garyt72/Alarm-Panel/docs/pcb/images/power-plug-bottom-angle.png

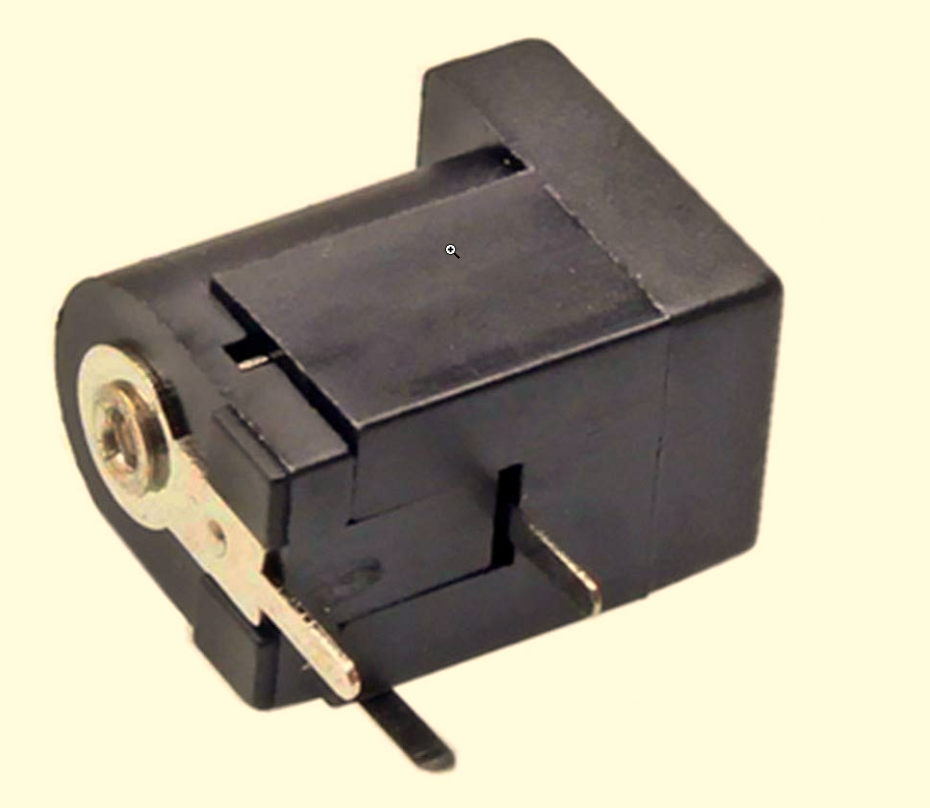
docs/pcb/images/power-plug-bottom-angle.png
