garyt72/Alarm-Panel/hardware/alarm-panel/Alarm Panel.pdf

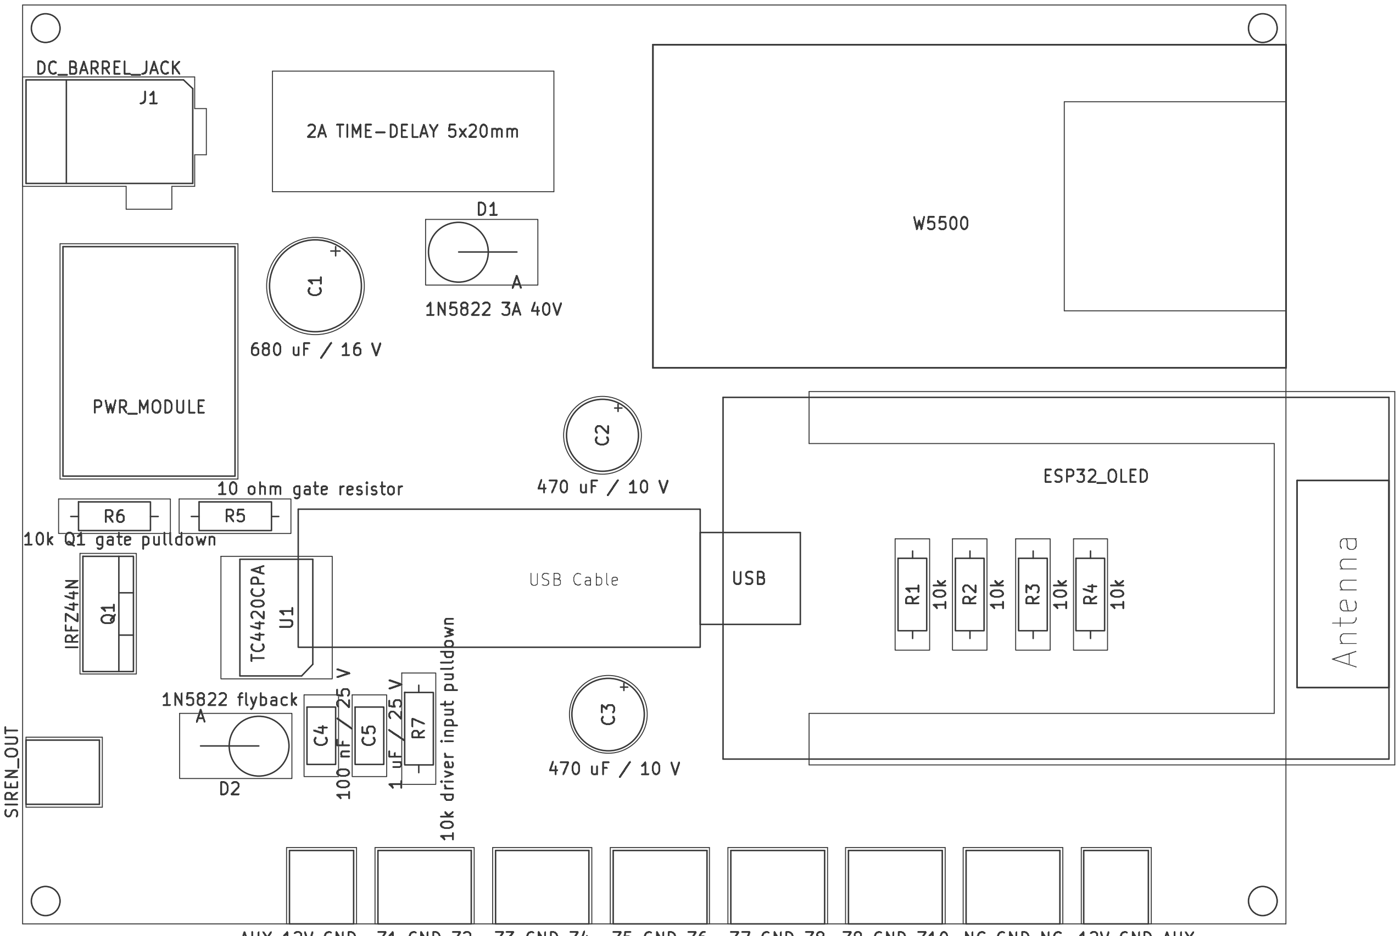
[picture p3: figure]

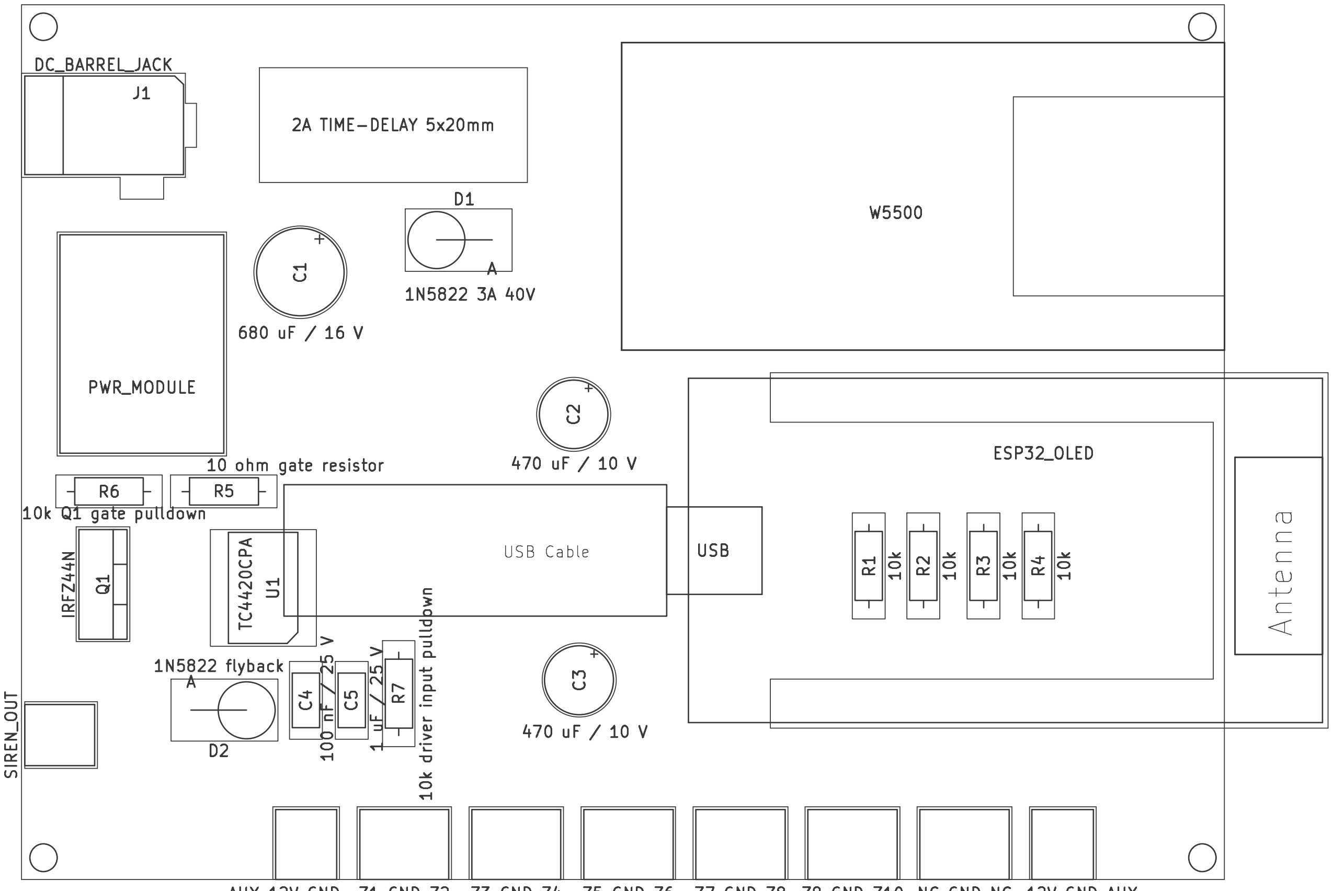
[picture p4: figure]
