garyt72/Alarm-Panel/docs/pcb/images/Fuse Holder Drawing.png

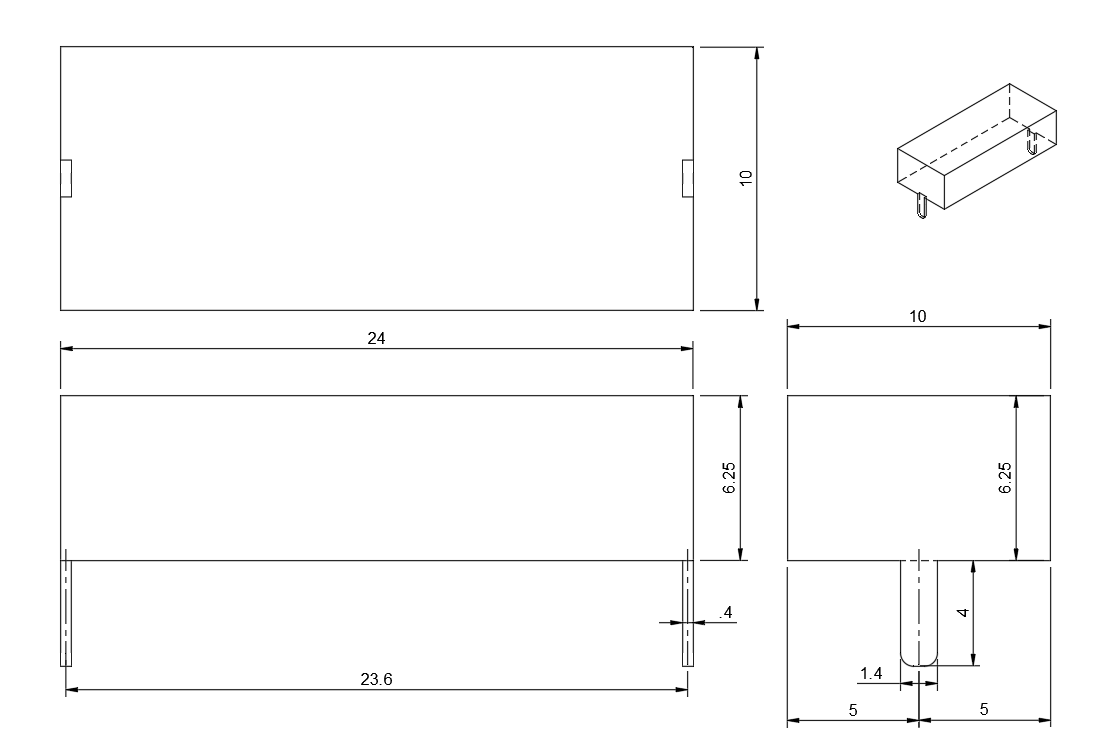
docs/pcb/images/Fuse Holder Drawing.png
