garyt72/Alarm-Panel/docs/pcb/images/power-plug-dimensions.png

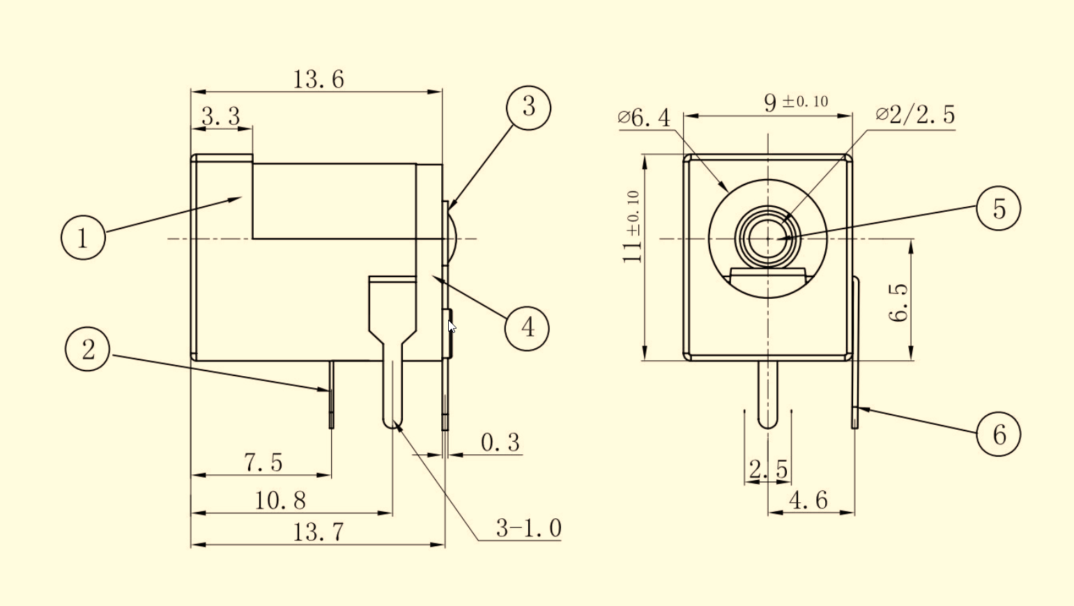
docs/pcb/images/power-plug-dimensions.png
