garyt72/Alarm-Panel/docs/pcb/images/w5500-bottom.png

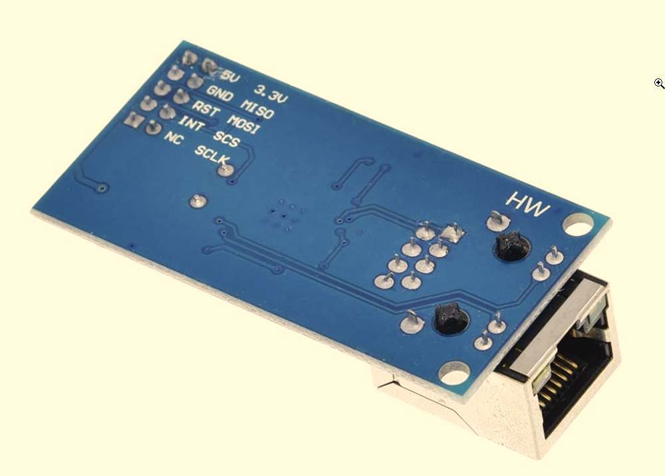
docs/pcb/images/w5500-bottom.png
