garyt72/Alarm-Panel/docs/pcb/images/w5500-dimensions.png

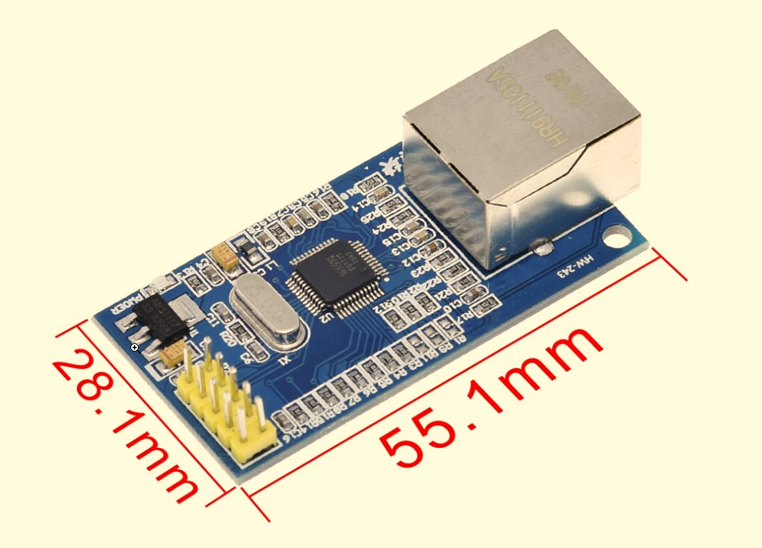
docs/pcb/images/w5500-dimensions.png
