garyt72/Alarm-Panel/docs/pcb/images/w5500-drawing.png

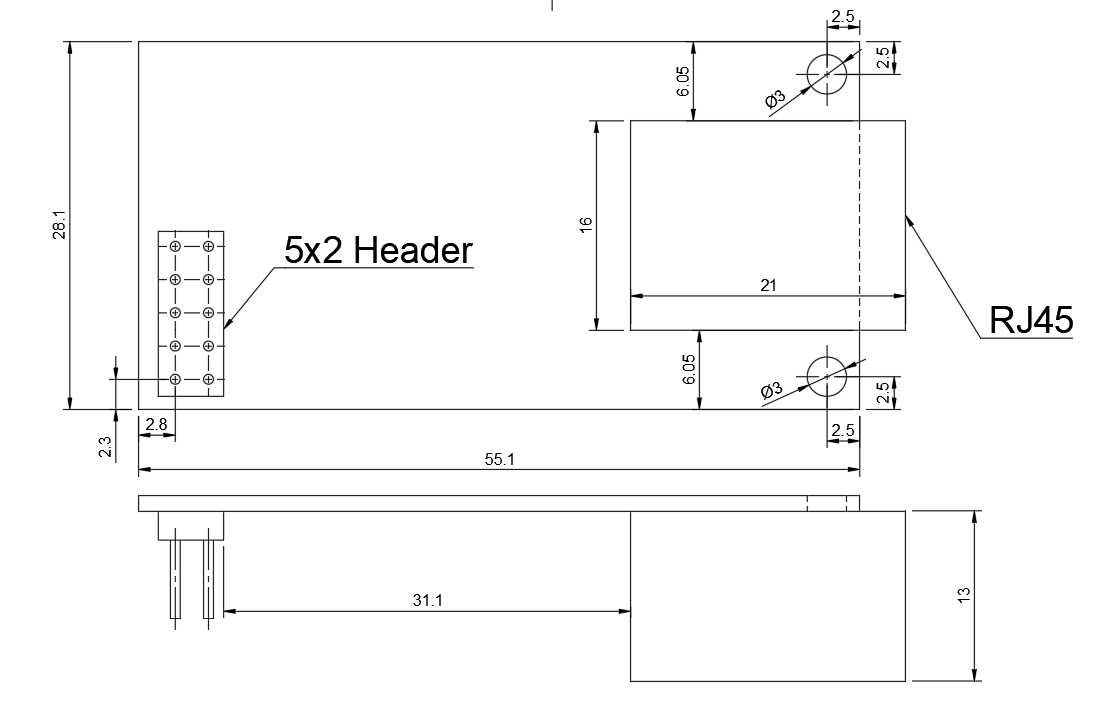
docs/pcb/images/w5500-drawing.png
