garyt72/Alarm-Panel/docs/pcb/images/w5500-top.jpg

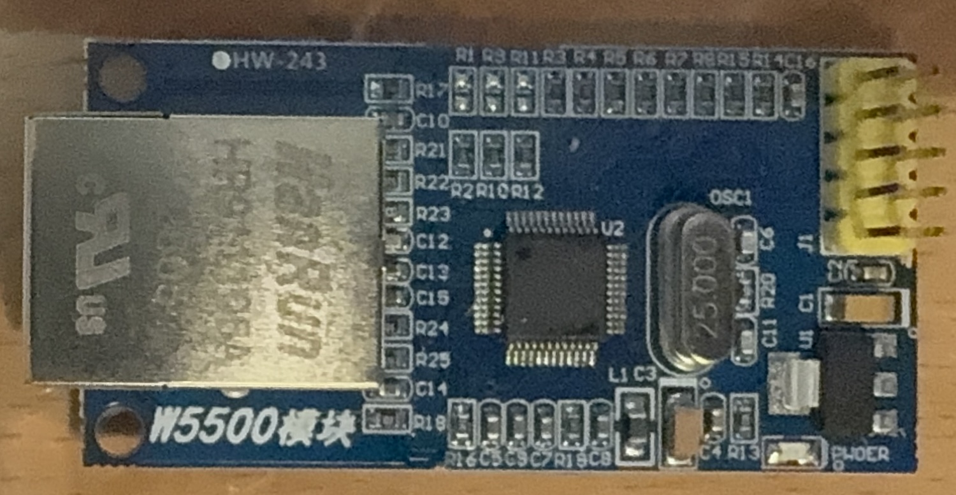
docs/pcb/images/w5500-top.jpg
