garyt72/Alarm-Panel/hardware/alarm-panel/3d-models/Fuse Holder.step

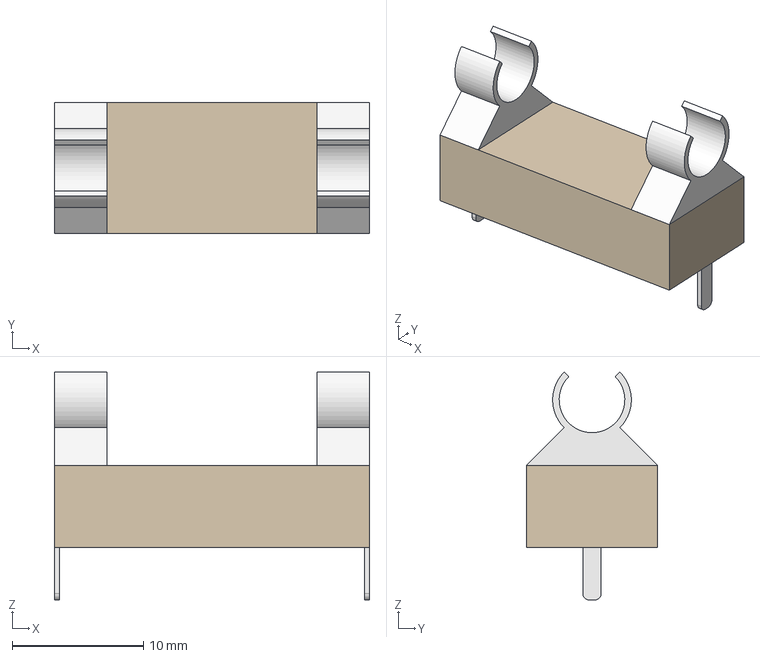
[picture p12: CAD file, 2026-10-27]
hardware/alarm-panel/3d-models/Fuse Holder.step
24.0 x 10.0 x 17.4 mm
