garyt72/Alarm-Panel/hardware/enclosure/3d-printing/PCB v1.0.0/Alarm Panel OLED case (PCB).step

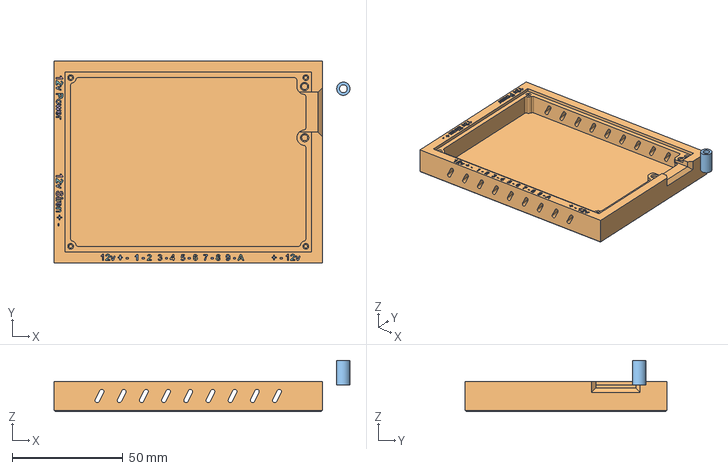
[picture p13: CAD file, 2026-11-01]
hardware/enclosure/3d-printing/PCB v1.0.0/Alarm Panel OLED case (PCB).step
133.4 x 91.0 x 23.0 mm
