garyt72/Alarm-Panel/hardware/alarm-panel/3d-models/Power Module.step

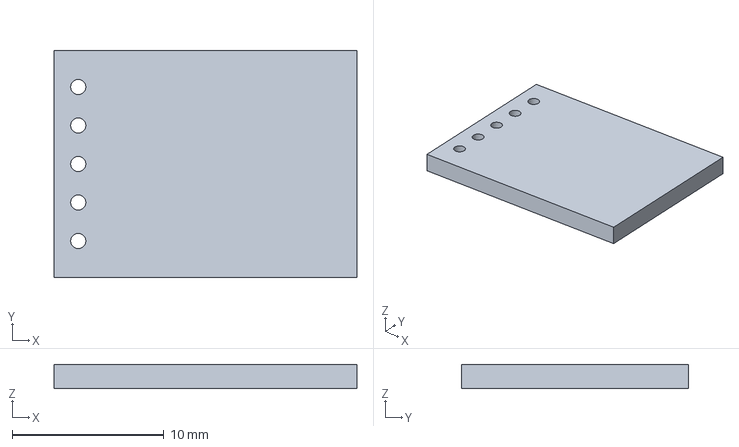
[picture p14: CAD file, 2026-10-27]
hardware/alarm-panel/3d-models/Power Module.step
20.0 x 15.0 x 1.60 mm
