garyt72/Alarm-Panel/hardware/enclosure/3d-printing/PCB v1.0.0/Alarm Panel OLED case (PCB) Ethernet Spacer.stl

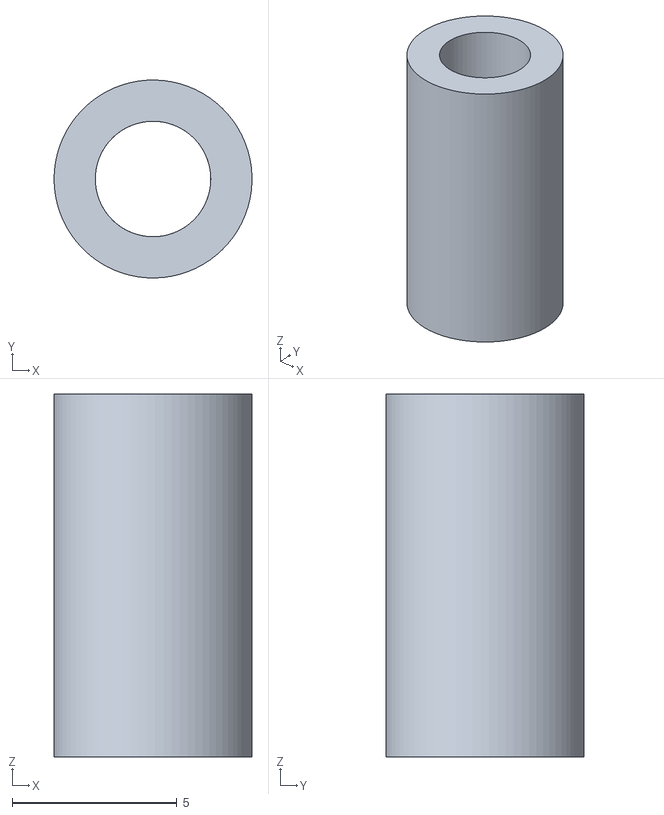
[picture p15: CAD file, 2026-11-01]
hardware/enclosure/3d-printing/PCB v1.0.0/Alarm Panel OLED case (PCB) Ethernet Spacer.stl
6.00 x 6.00 x 11.0
