garyt72/Alarm-Panel/hardware/alarm-panel/3d-models/esp32_Wroom_CP2102_Ideaspark_0.96in_OLED_USBmicro.step

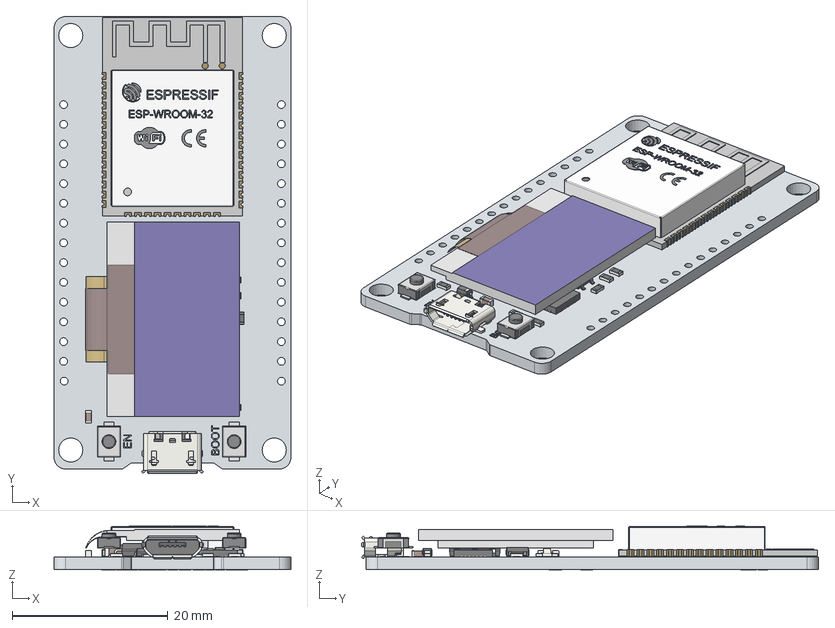
[picture p16: CAD file, 2026-10-27]
hardware/alarm-panel/3d-models/esp32_Wroom_CP2102_Ideaspark_0.96in_OLED_USBmicro.step
30.5 x 58.8 x 5.60 mm
