garyt72/Alarm-Panel/hardware/alarm-panel/3d-models/W5500_Ethernet_Module_HiLetgo.step

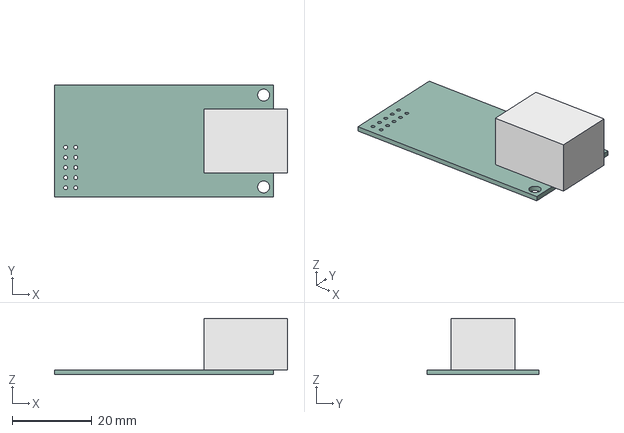
[picture p17: CAD file, 2026-10-27]
hardware/alarm-panel/3d-models/W5500_Ethernet_Module_HiLetgo.step
58.6 x 28.1 x 14.2 mm
