garyt72/Alarm-Panel/hardware/enclosure/3d-printing/legacy/Alarm Panel OLED case.stl

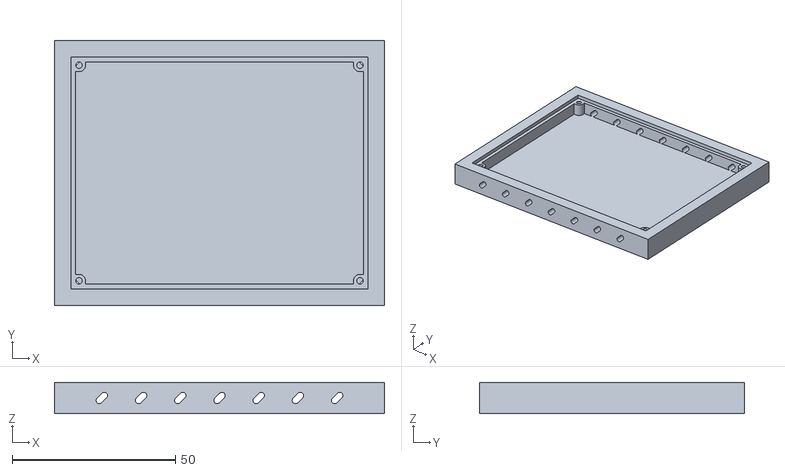
[picture p18: CAD file, 2026-10-25, an earlier design]
hardware/enclosure/3d-printing/legacy/Alarm Panel OLED case.stl
101.0 x 81.0 x 9.50
