garyt72/Alarm-Panel/(list of files, cad)

Other CAD files:
hardware/enclosure/3d-printing/PCB v1.0.0/Alarm Panel OLED case (PCB).stl
