garyt72/Alarm-Panel/hardware/alarm-panel/Alarm Panel.kicad_pcb

## KiCad design hardware/alarm-panel/Alarm Panel.kicad_pcb (2026-11-01)

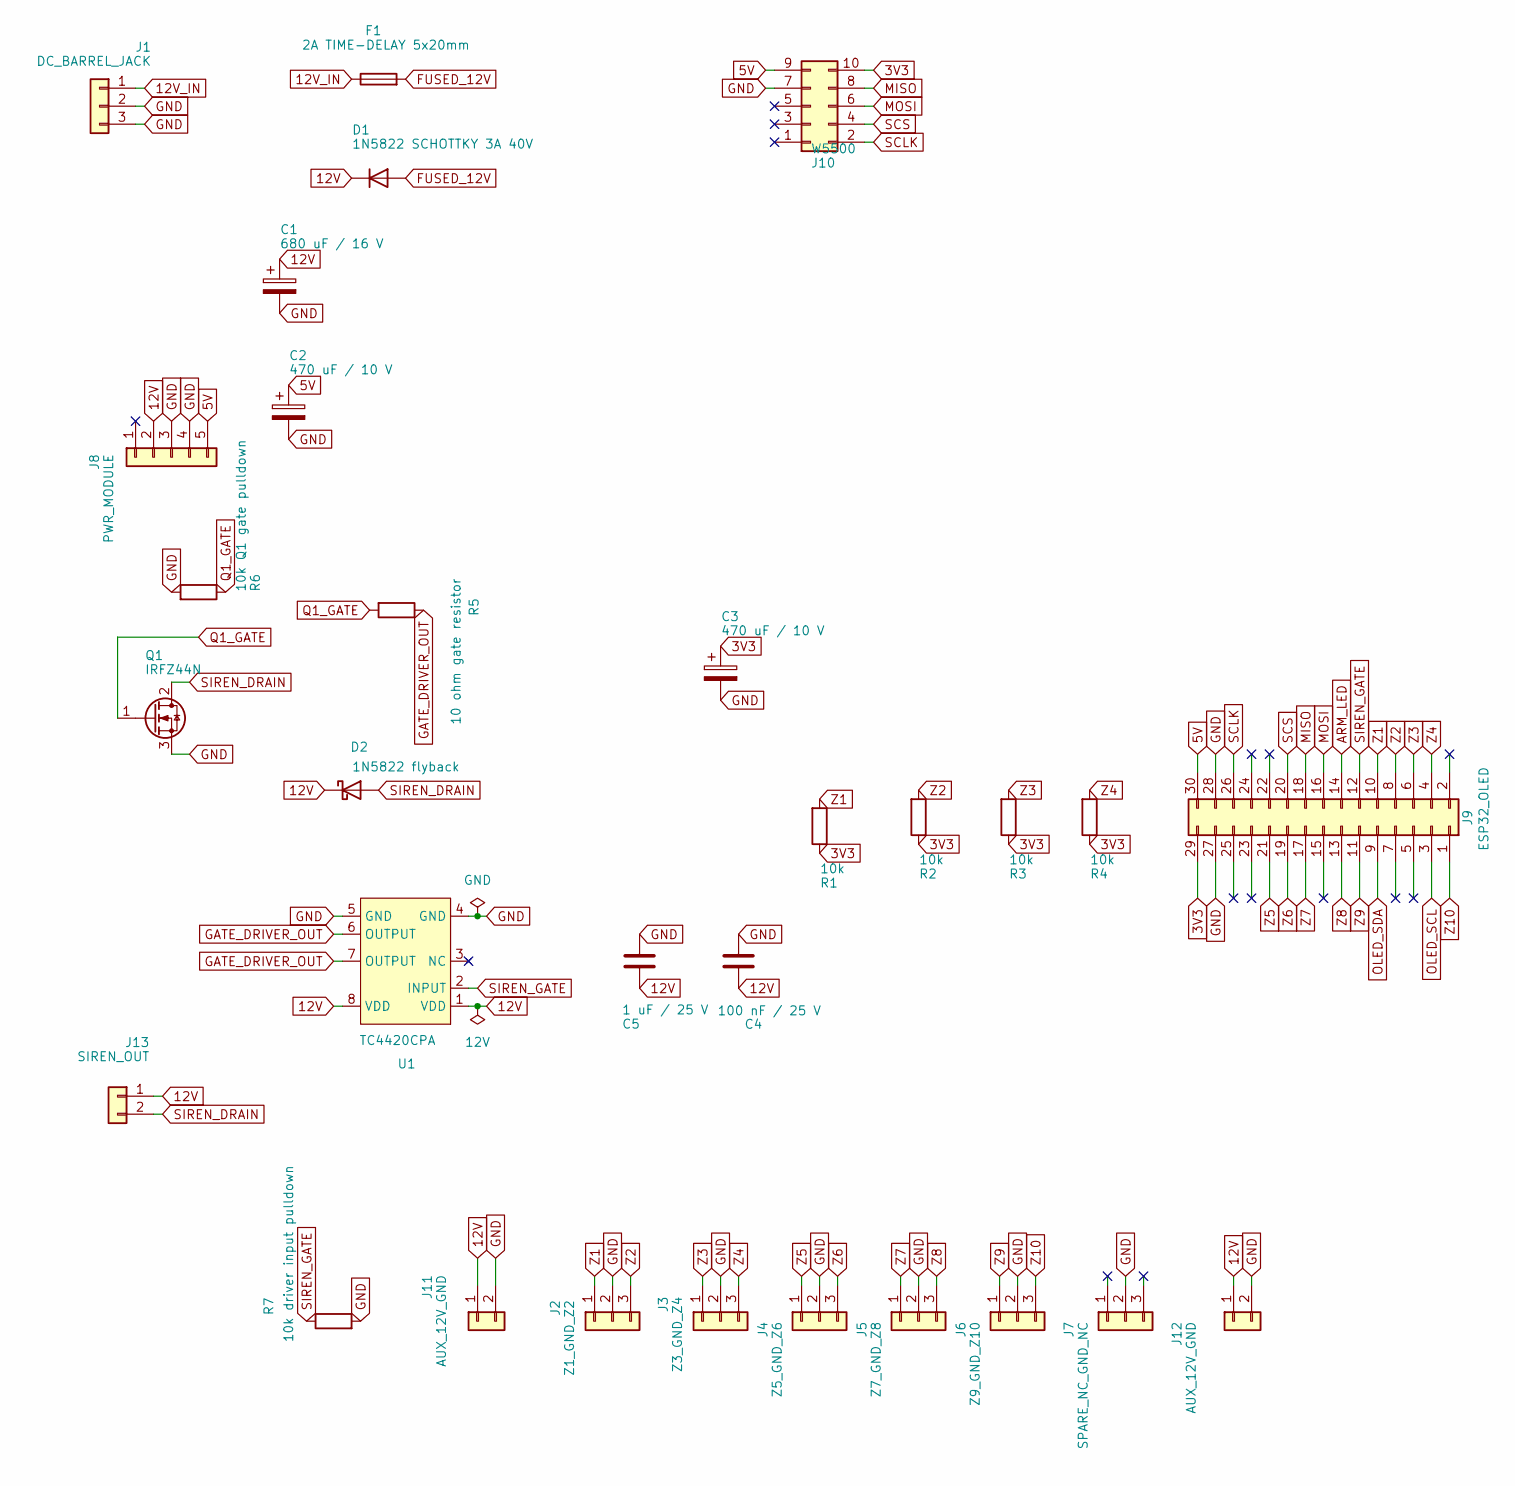
[picture p19: schematic Alarm Panel.kicad_sch]

Parts:
C1: 680 uF / 16 V; CP_Radial_D8.0mm_P3.50mm
C2, C3: 470 uF / 10 V; CP_Radial_D6.3mm_P2.50mm
C4: 100 nF / 25 V; C_Disc_D5.0mm_W2.5mm_P5.00mm
C5: 1 uF / 25 V; C_Disc_D5.0mm_W2.5mm_P5.00mm
D1: 1N5822 SCHOTTKY 3A 40V; D_DO-201AD_P5.08mm_Vertical_AnodeUp
D2: 1N5822 flyback; D_DO-201AD_P5.08mm_Vertical_AnodeUp
F1: 2A TIME-DELAY 5x20mm; FuseHolder_Body24x10_P23.6mm
J1: DC_BARREL_JACK; BarrelJack_Horizontal
J2: Z1_GND_Z2; TerminalBlock_1x03_P2.54mm_Body8.15x6.40mm
J3: Z3_GND_Z4; TerminalBlock_1x03_P2.54mm_Body8.15x6.40mm
J4: Z5_GND_Z6; TerminalBlock_1x03_P2.54mm_Body8.15x6.40mm
J5: Z7_GND_Z8; TerminalBlock_1x03_P2.54mm_Body8.15x6.40mm
J6: Z9_GND_Z10; TerminalBlock_1x03_P2.54mm_Body8.15x6.40mm
J7: SPARE_NC_GND_NC; TerminalBlock_1x03_P2.54mm_Body8.15x6.40mm
J8: PWR_MODULE; PowerModule_1x05_P2.54mm_Body15x20mm
J9: ESP32_OLED; ESP32_OLED_2x15_P2.54mm_Row27.94mm
J10: W5500; W5500_2x5_P2.54mm_Module55.1x28.1mm
J11, J12: AUX_12V_GND; TerminalBlock_1x02_P2.54mm_Body5.60x6.40mm
J13: SIREN_OUT; TerminalBlock_1x02_P2.54mm_Body5.60x6.40mm
Q1: IRFZ44N; TO-220-3_Vertical
R1, R2, R3, R4: 10k; R_Axial_DIN0207_L6.3mm_D2.5mm_P7.62mm_Horizontal
R5: 10 ohm gate resistor; R_Axial_DIN0207_L6.3mm_D2.5mm_P7.62mm_Horizontal
R6: 10k Q1 gate pulldown; R_Axial_DIN0207_L6.3mm_D2.5mm_P7.62mm_Horizontal
R7: 10k driver input pulldown; R_Axial_DIN0207_L6.3mm_D2.5mm_P7.62mm_Horizontal
U1: TC4420CPA; DIP-8_W7.62mm

Connections:
3V3: C3.1, J9.29, J10.10, R1.1, R2.1, R3.1, R4.1
5V: C2.1, J8.5, J9.30, J10.9
12V: C1.1, C4.1, C5.1, D1.1 (K), D2.1 (K), J8.2, J11.1, J12.1, J13.1, U1.1 (VDD), U1.8 (VDD)
12V_IN: F1.1, J1.1
ARM_LED: J9.14
FUSED_12V: D1.2 (A), F1.2
GATE_DRIVER_OUT: R5.1, U1.6 (OUTPUT), U1.7 (OUTPUT)
GND: C1.2, C2.2, C3.2, C4.2, C5.2, J1.2, J1.3, J2.2, J3.2, J4.2, J5.2, J6.2, J7.2 (Pin_2_2), J8.3, J8.4, J9.27, J9.28, J10.7, J11.2, J12.2, Q1.3 (S), R6.2, R7.2, U1.4 (GND), U1.5 (GND)
MISO: J9.18, J10.8
MOSI: J9.16, J10.6
OLED_SCL: J9.3
OLED_SDA: J9.9
Q1_GATE: Q1.1 (G), R5.2, R6.1
SCLK: J9.26, J10.2
SCS: J9.20, J10.4
SIREN_DRAIN: D2.2 (A), J13.2, Q1.2 (D)
SIREN_GATE: J9.12, R7.1, U1.2 (INPUT)
Z1: J2.1, J9.10, R1.2
Z2: J2.3, J9.8, R2.2
Z3: J3.1, J9.6, R3.2
Z4: J3.3, J9.4, R4.2
Z5: J4.1, J9.21
Z6: J4.3, J9.19
Z7: J5.1, J9.17
Z8: J5.3, J9.13
Z9: J6.1, J9.11
Z10: J6.3, J9.1

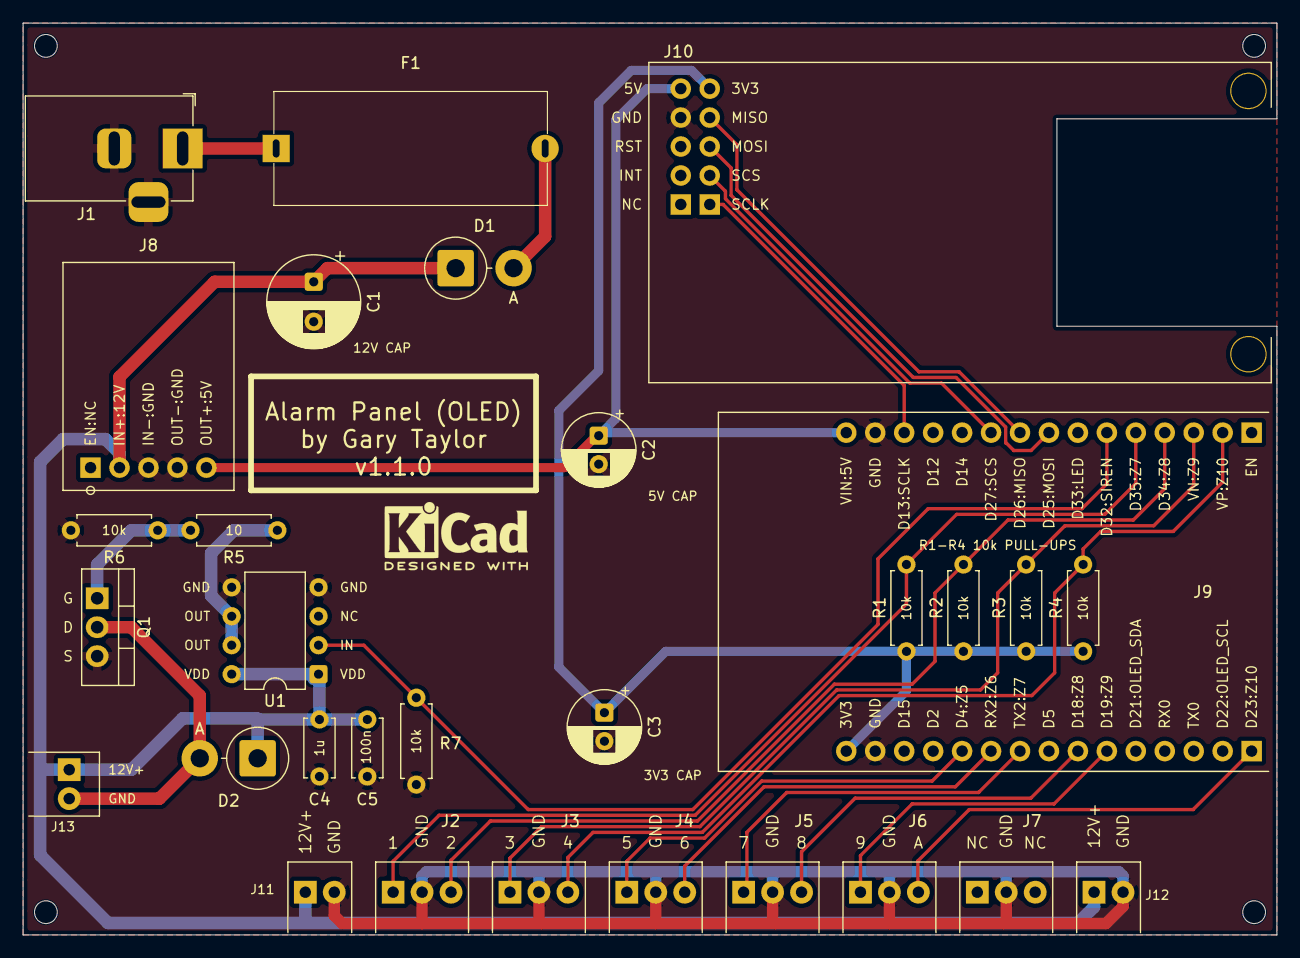
[picture p20: board Alarm Panel.kicad_pcb from above]

Board: 2 copper layers, 110.0 x 80.0 mm, 34 parts (0 on the bottom side), 24 nets.

Other parts of the board:
H1, H2, H3, H4: 2.0 mm NPTH; MountingHole_NPTH_2.0mm
