garyt72/Alarm-Panel/(commit log)

2026-10-09 On branch main Changes to be committed: new file: .gitignore modified: README.md new file: devices/alarm-panel-oled.yaml new file: packages/boards/esp32dev.yaml new file: secrets.example.yaml
2026-10-09 On branch Ethernet-Patch Changes to be committed: modified: README.md modified: devices/alarm-panel-oled.yaml new file: docs/pinout-and-ethernet.md
2026-10-25 Add initial alarm panel PCB design
    [Alarm Panel OLED case.stl, Alarm Panel.kicad_pcb, Alarm Panel.kicad_sch]
2026-10-25 Update PCB layout and organize project structure
    [Alarm Panel OLED case.stl, Alarm Panel.kicad_pcb, Alarm Panel.kicad_sch]
2026-10-25 On branch Gerber-Files-Created Changes to be committed: modified: docs/pcb/pcb-completion-checklist.md modified: hardware/alarm-panel/Alarm Panel.kicad_pcb new file: hardware/alarm-panel/gerbers/Alar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
    [Alarm Panel-B_Cu.gbl, Alarm Panel-B_Mask.gbs, Alarm Panel-B_Silkscreen.gbo, Alarm Panel-Edge_Cuts.gm1, Alarm Panel-F_Cu.gtl, Alarm Panel-F_Mask.gts, Alarm Panel-F_Silkscreen.gto, Alarm Panel-NPTH.drl]
2026-10-26 Fixed Track Widths. Fixes #10.
    [Alarm Panel.kicad_pcb]
2026-10-26 Added silkscreen for footprint of F1. Fixes #4.
    [Alarm Panel.kicad_pcb]
2026-10-26 fixed missplaced silkscreen value for C5. Fixes C5 value missplaced Fixes #5
    [Alarm Panel.kicad_pcb]
2026-10-26 bump silkscreen version number on PCB. Rename gerber zip file to include version and JLCPCB reference.
    [Alarm Panel.kicad_pcb]
2026-10-27 Added all missing 3d models. Fixes #6, #7, #8, #9, #13
    [Alarm Panel.kicad_pcb, Fuse Holder.step, Power Module.step, W5500_Ethernet_Module_HiLetgo.step, esp32_Wroom_CP2102_Ideaspark_0.96in_OLED_USBmicro.step]
2026-11-01 Update alarm panel design files and footprints
    - Modified the KiCad project file to include new differential pair dimensions and DRC exclusions.
    - Changed DRC settings to issue warnings for footprint type mismatches and missing courtyards.
    - Updated minimum track width from 0.2mm to 0.3mm and adjusted track widths to include a default value.
    - Added new ngspice configuration to the project file.
    - Updated schematic to change footprint references for fuse holders and capacitors.
    - Corrected capacitor voltage rating from 18V to 16V.
    - Revised footprint for Fuse Holder to include additional properties and updated dimensions.
    - Added a new STEP model for the alarm panel.
    Update ESPHome configur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
    [Alarm Panel OLED case (PCB) Ethernet Spacer.stl, Alarm Panel OLED case (PCB).step, Alarm Panel OLED case (PCB).stl, Alarm Panel.kicad_pcb, Alarm Panel.kicad_sch, Alarm Panel.step]
2026-11-01 deleted: hardware/alarm-panel/Alarm Panel.step
    [Alarm Panel.step]
