garyt72/Alarm-Panel/docs/pcb/images/power-board-pins.png

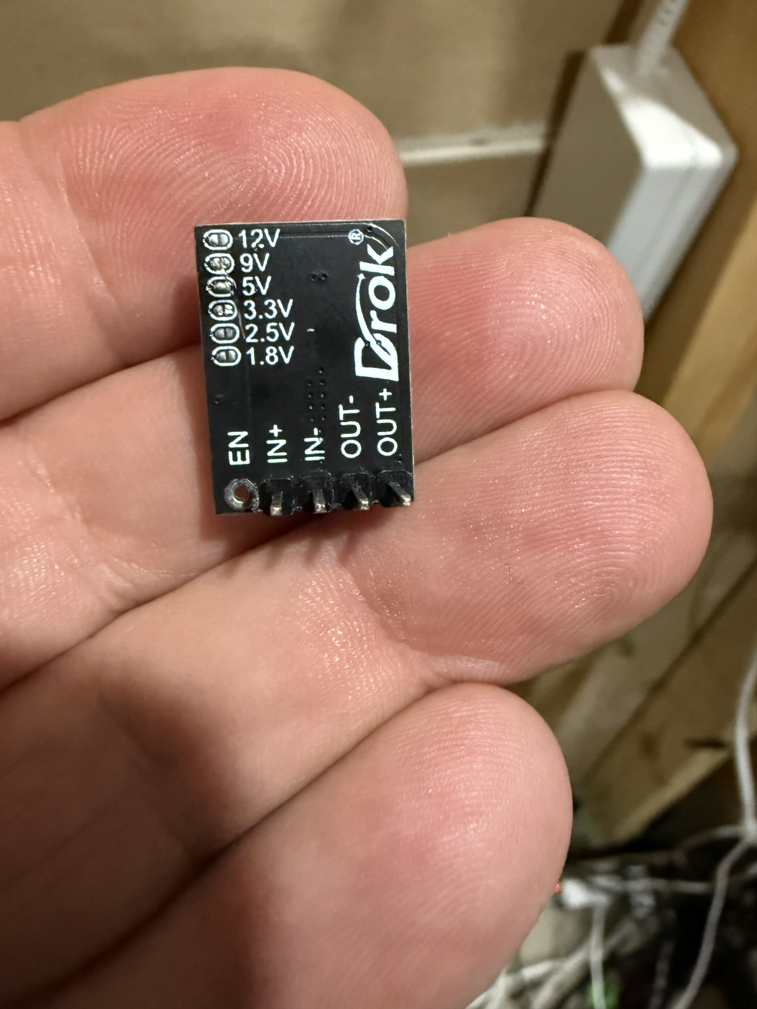
docs/pcb/images/power-board-pins.png
