garyt72/Alarm-Panel/docs/pcb/images/top-board-assembled-powered-on.png

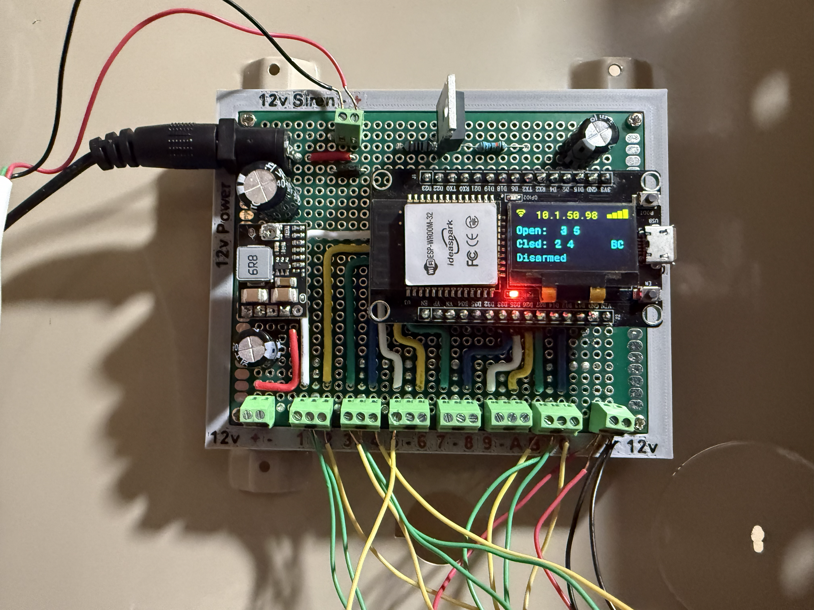
docs/pcb/images/top-board-assembled-powered-on.png
